MattERoche/Wheelchair-Powermeter/Report and Planning/WhatsApp Image 2025-04-04 at 15.48.07_d8d99685.jpg

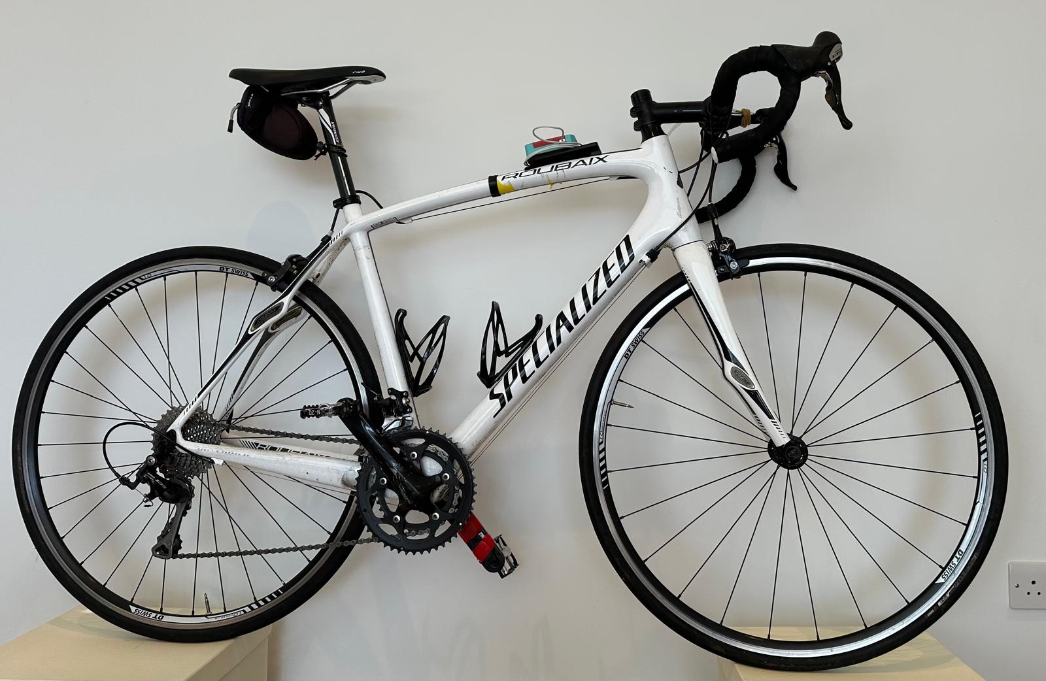
Report and Planning/WhatsApp Image 2025-04-04 at 15.48.07_d8d99685.jpg
