MattERoche/Wheelchair-Powermeter/Report and Planning/WhatsApp Image 2025-04-07 at 23.08.40_146ae403.jpg

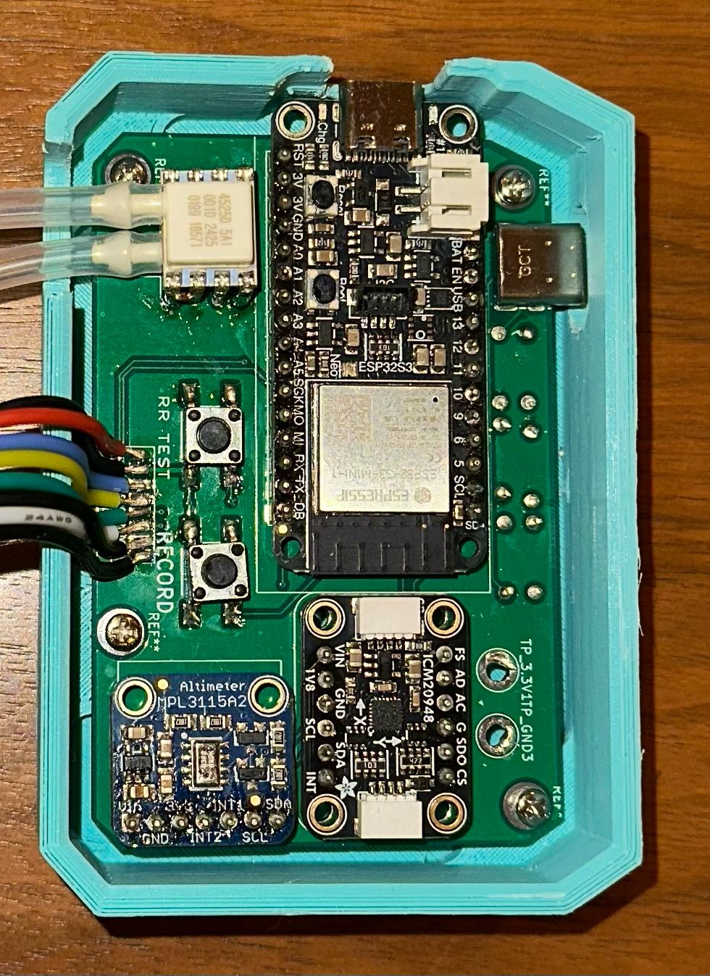
Report and Planning/WhatsApp Image 2025-04-07 at 23.08.40_146ae403.jpg
