MattERoche/Wheelchair-Powermeter/Data_Store/Data_V1_CirPY/Drag% PY.png

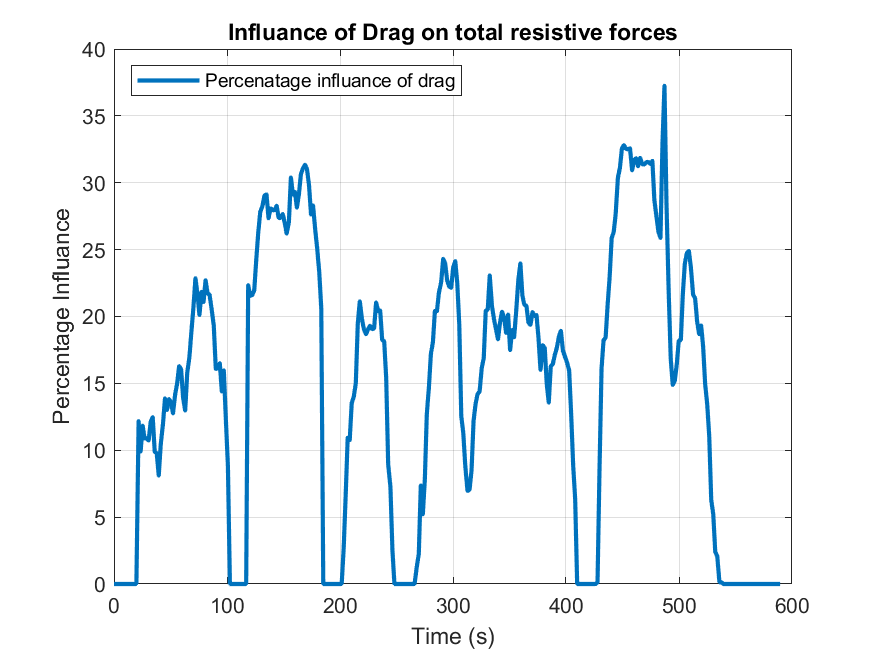
Data_Store/Data_V1_CirPY/Drag% PY.png
