MattERoche/Wheelchair-Powermeter/Data_Store/Data_V1_CirPY/Pitot.png

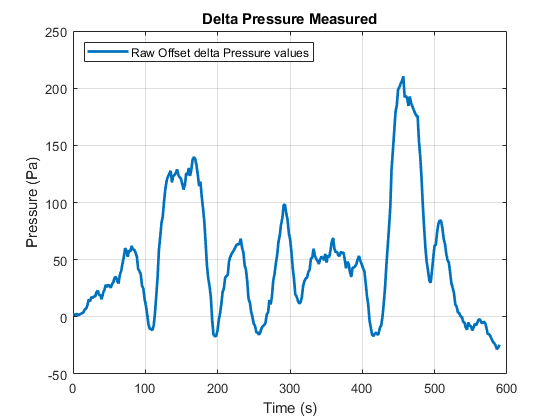
Data_Store/Data_V1_CirPY/Pitot.png
