MattERoche/Wheelchair-Powermeter/Data_Store/Data_V1_CirPY/RR VS Drag PY.png

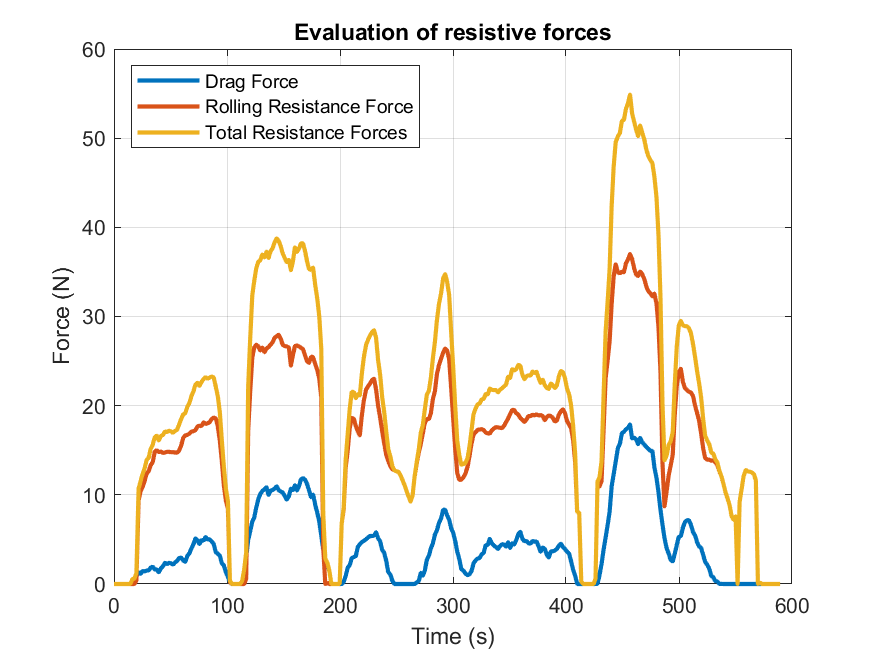
Data_Store/Data_V1_CirPY/RR VS Drag PY.png
