MattERoche/Wheelchair-Powermeter/Data_Store/Data_V1_CirPY/UnfillteredAccel.png

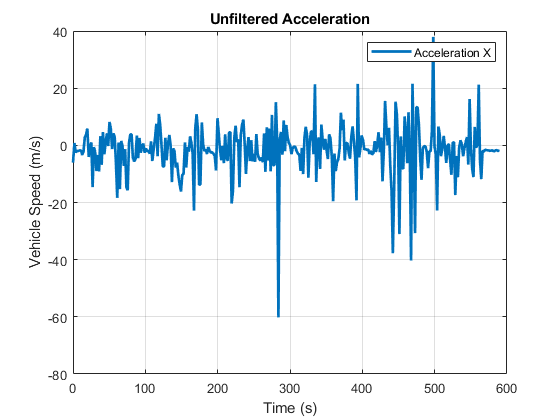
Data_Store/Data_V1_CirPY/UnfillteredAccel.png
