MattERoche/Wheelchair-Powermeter/Data_Store/Data_V1_CirPY/Windspeed vs Vehicle Velocity Circ Py.png

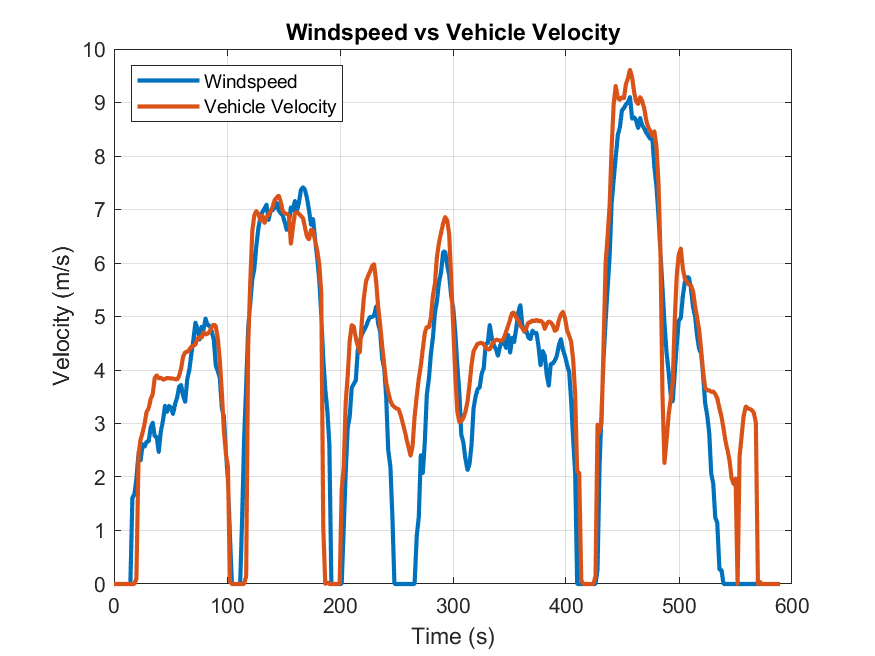
Data_Store/Data_V1_CirPY/Windspeed vs Vehicle Velocity Circ Py.png
