MattERoche/Wheelchair-Powermeter/Data_Store/Data_V2_C++_0330/Accel Vs speed delay.png

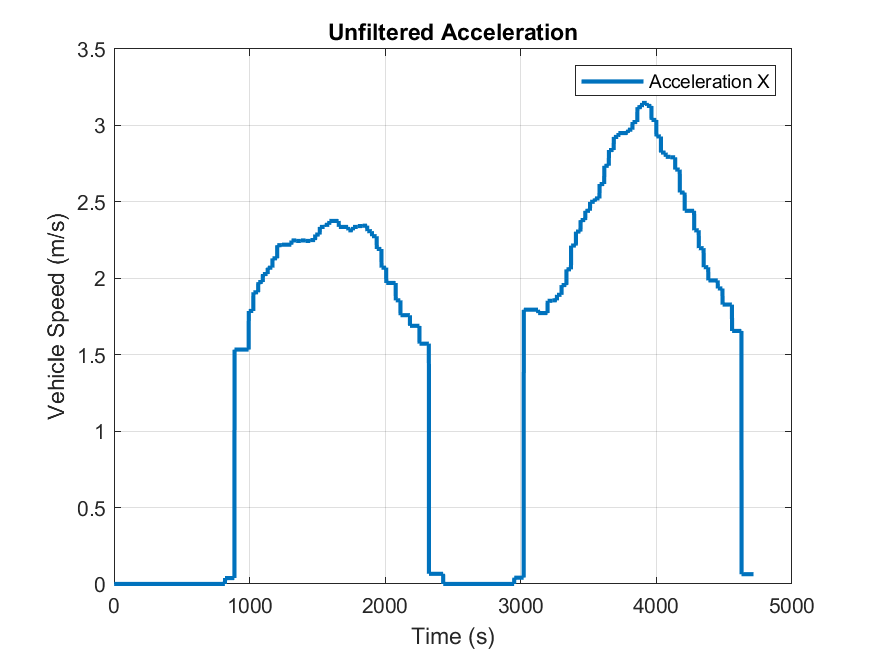
Data_Store/Data_V2_C++_0330/Accel Vs speed delay.png
