MattERoche/Wheelchair-Powermeter/Data_Store/Data_V2_C++_0330/BLE Power Ref.png

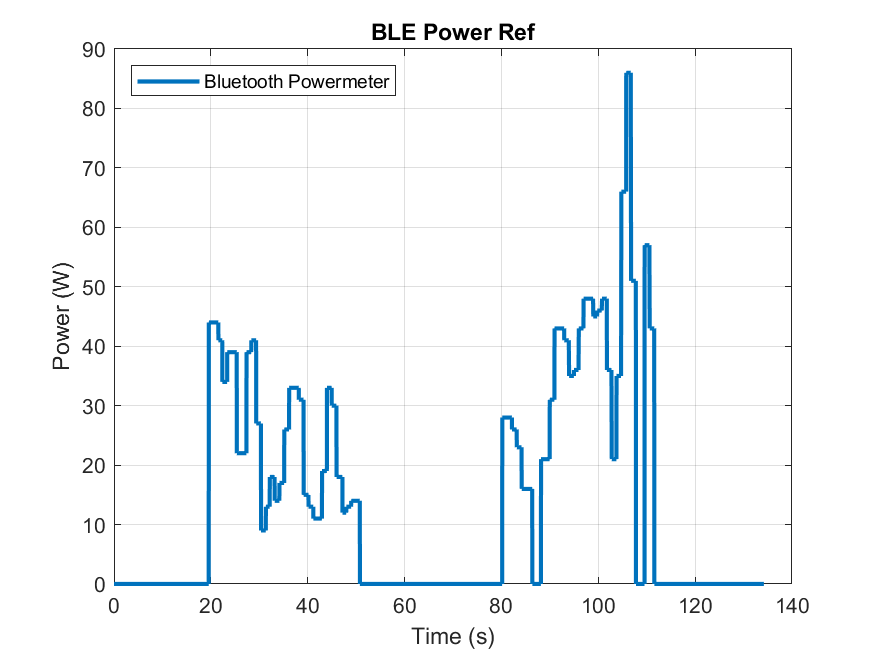
Data_Store/Data_V2_C++_0330/BLE Power Ref.png
