MattERoche/Wheelchair-Powermeter/Data_Store/Data_V2_C++_0330/BLE Velocity Sensor.png

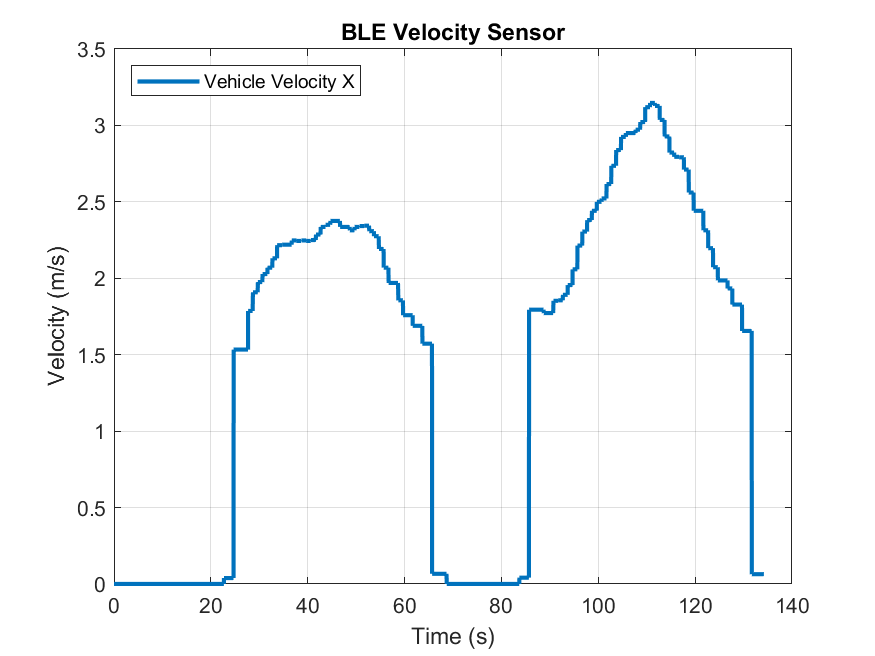
Data_Store/Data_V2_C++_0330/BLE Velocity Sensor.png
