MattERoche/Wheelchair-Powermeter/Data_Store/Data_V2_C++_0330/PowerVsPower.png

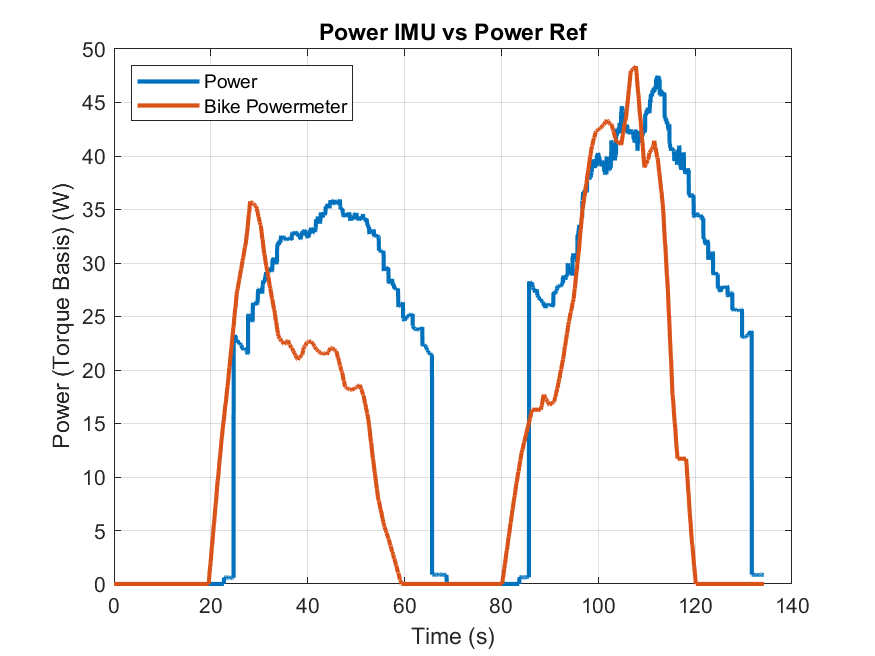
Data_Store/Data_V2_C++_0330/PowerVsPower.png
