MattERoche/Wheelchair-Powermeter/Data_Store/Data_V2_C++_0330/Resistive Forces.png

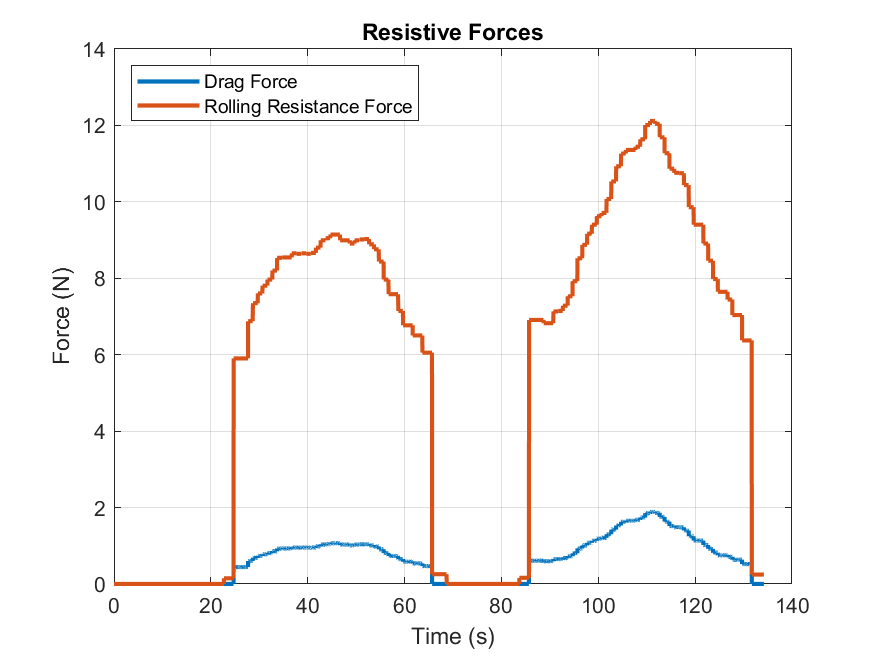
Data_Store/Data_V2_C++_0330/Resistive Forces.png
