MattERoche/Wheelchair-Powermeter/Data_Store/Data_V2_C++_0330/Windspeed vs Vehicle Velocity.png

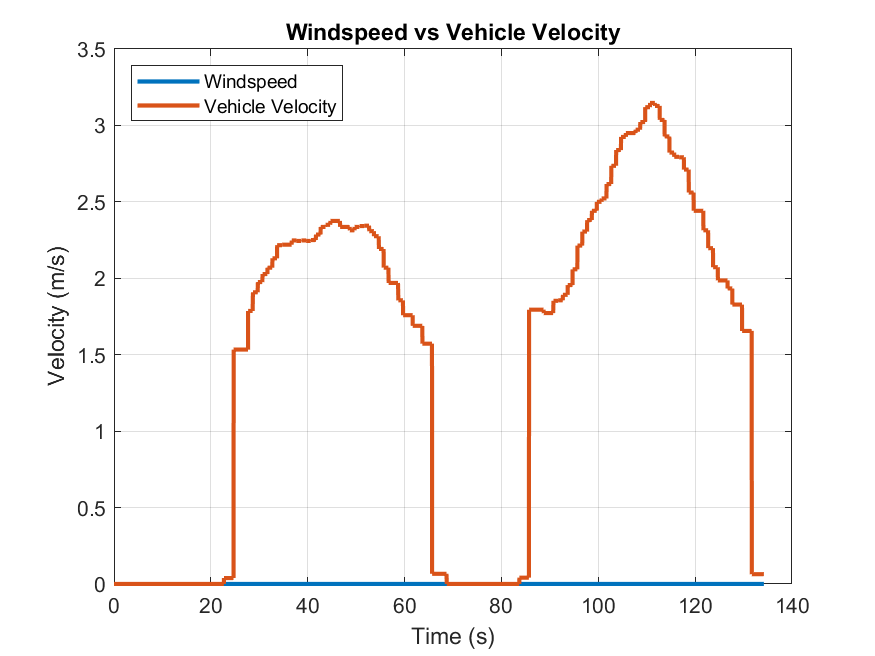
Data_Store/Data_V2_C++_0330/Windspeed vs Vehicle Velocity.png
