MattERoche/Wheelchair-Powermeter/Report and Planning/Fig4 Filter Example.png

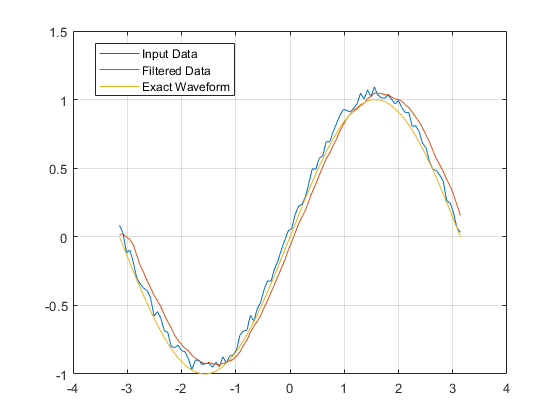
Report and Planning/Fig4 Filter Example.png
