MattERoche/Wheelchair-Powermeter/Report and Planning/Fig5 Filter Shift Example.png

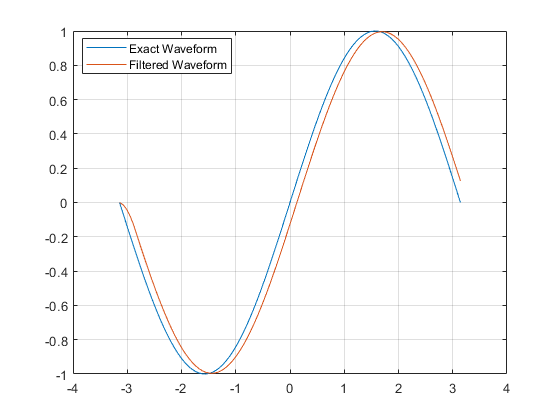
Report and Planning/Fig5 Filter Shift Example.png
