MattERoche/Wheelchair-Powermeter/Report and Planning/Fig_Power.png

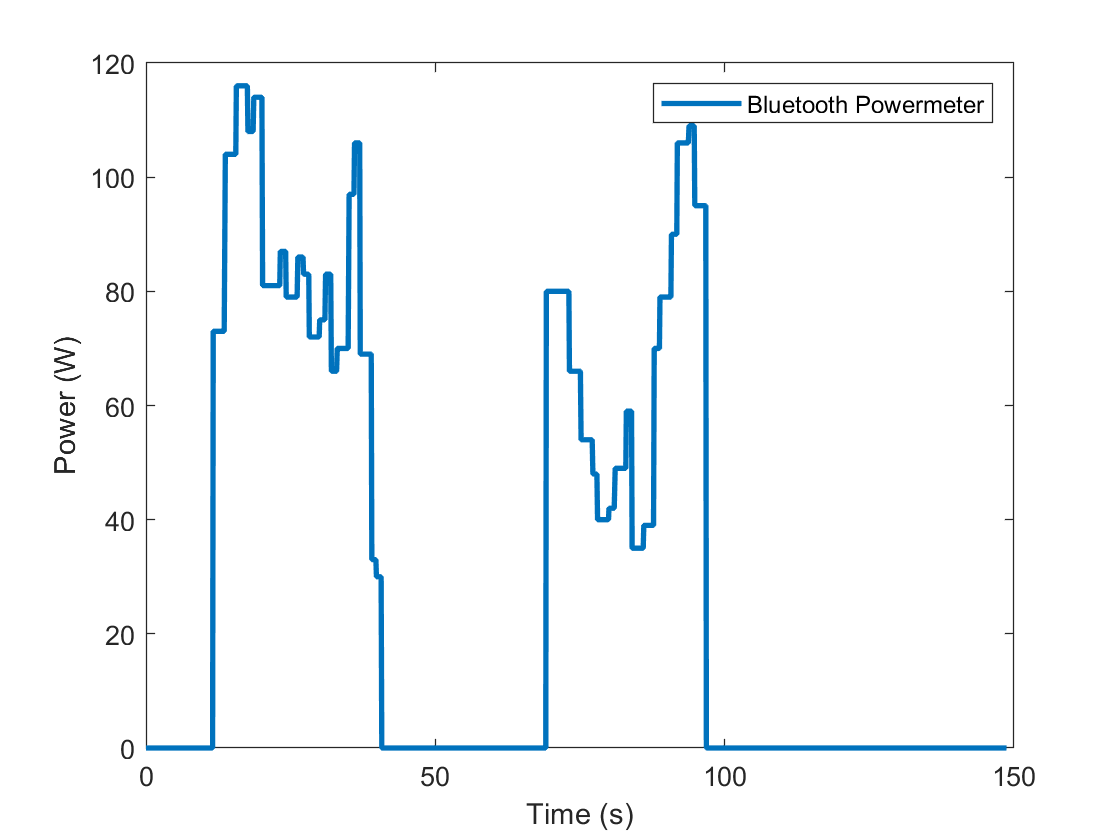
Report and Planning/Fig_Power.png
