MattERoche/Wheelchair-Powermeter/Report and Planning/Fig_speed.png

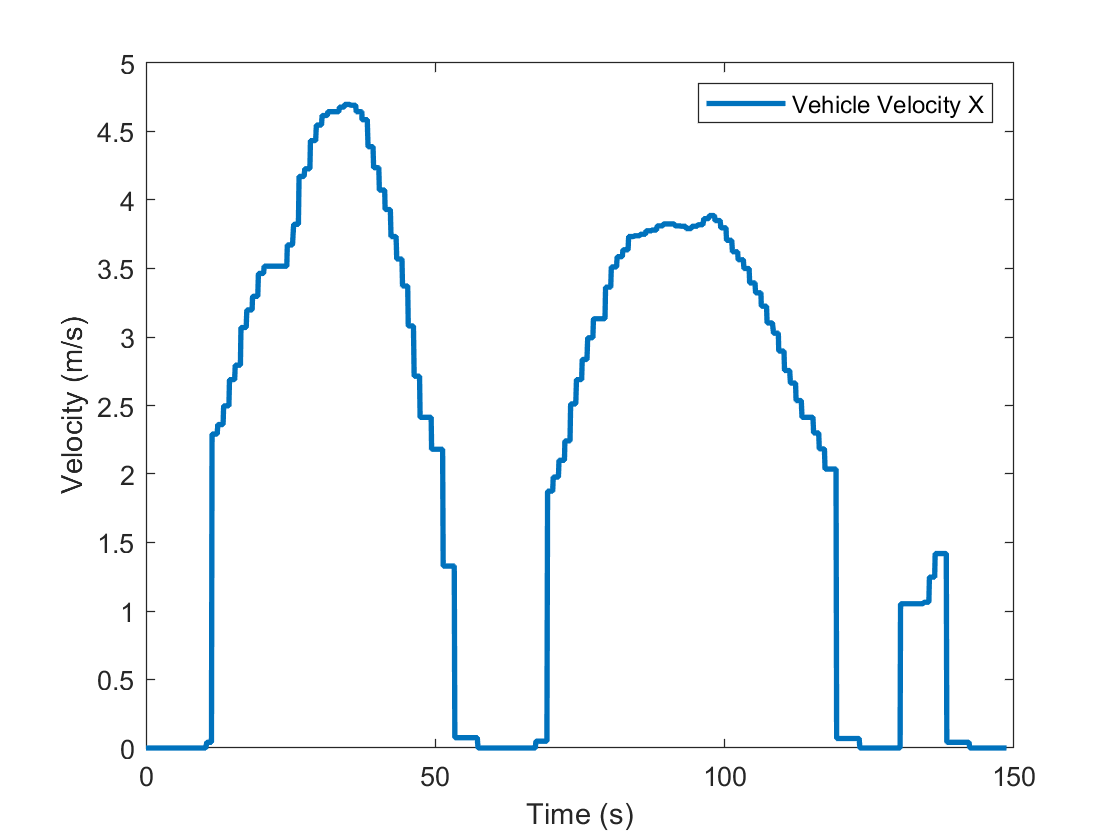
Report and Planning/Fig_speed.png
