MattERoche/Wheelchair-Powermeter/Report and Planning/figure-accellerometer response Run1.png

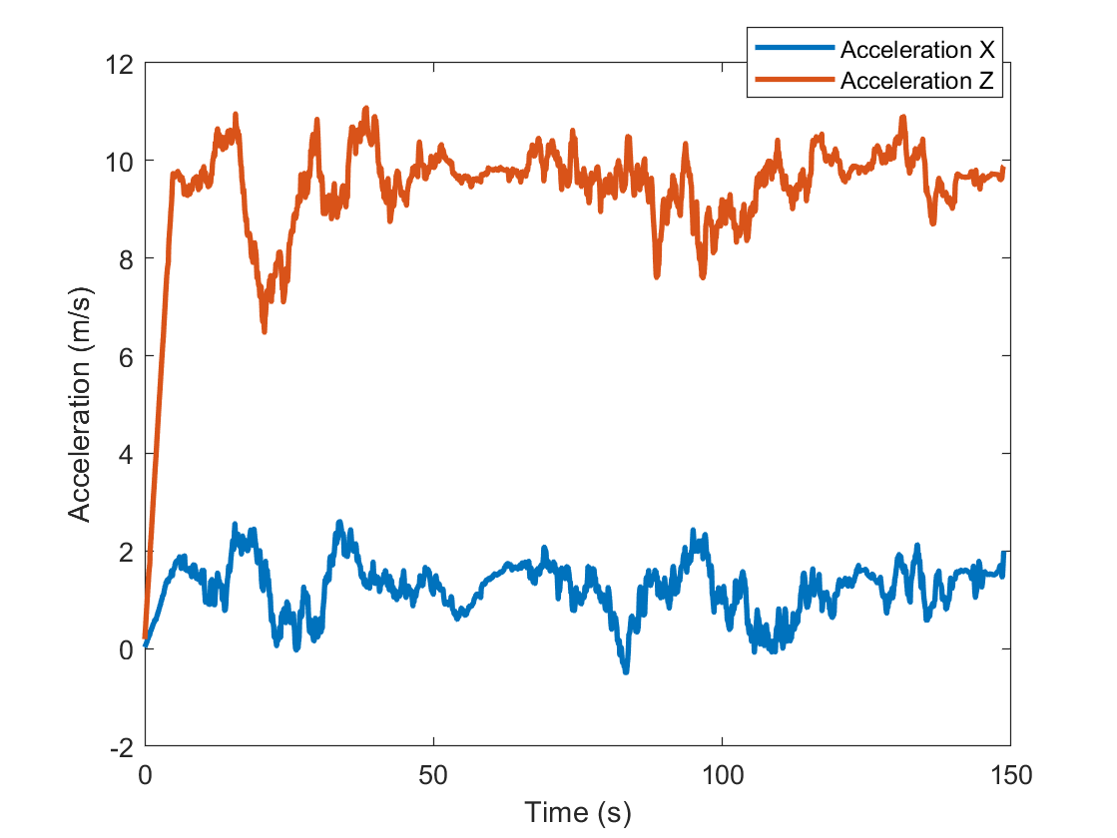
Report and Planning/figure-accellerometer response Run1.png
