MattERoche/Wheelchair-Powermeter/Report and Planning/Figures For Diss-2.jpg

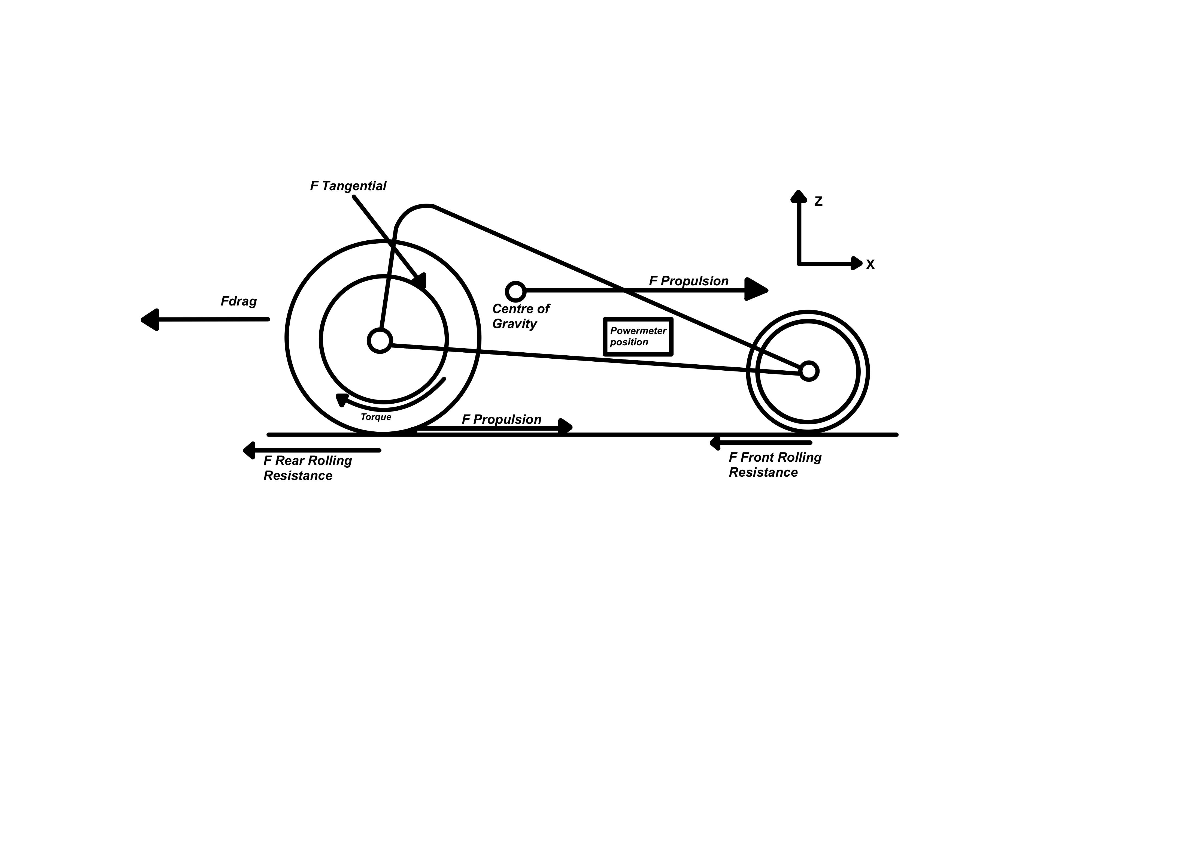
Report and Planning/Figures For Diss-2.jpg
