MattERoche/Wheelchair-Powermeter/Report and Planning/Figures For Diss-5.jpg

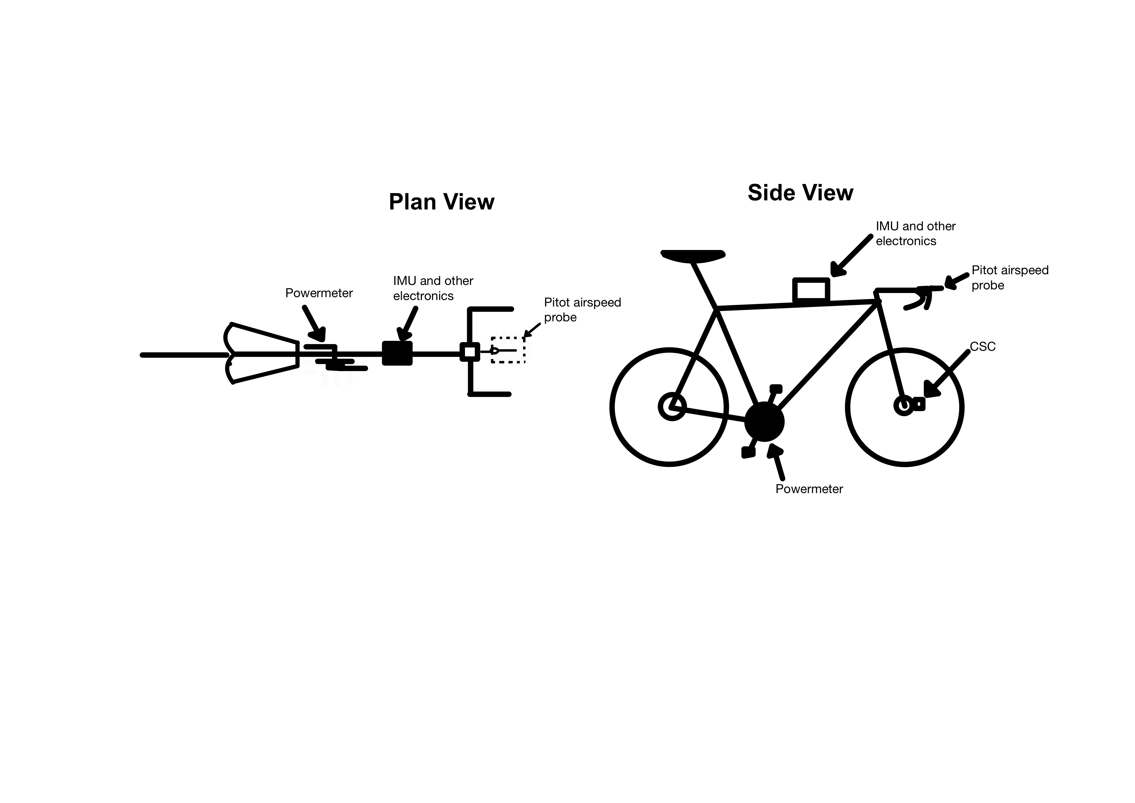
Report and Planning/Figures For Diss-5.jpg
