MattERoche/Wheelchair-Powermeter/Report and Planning/Wheelpower Sensor Flow - Page 2.png

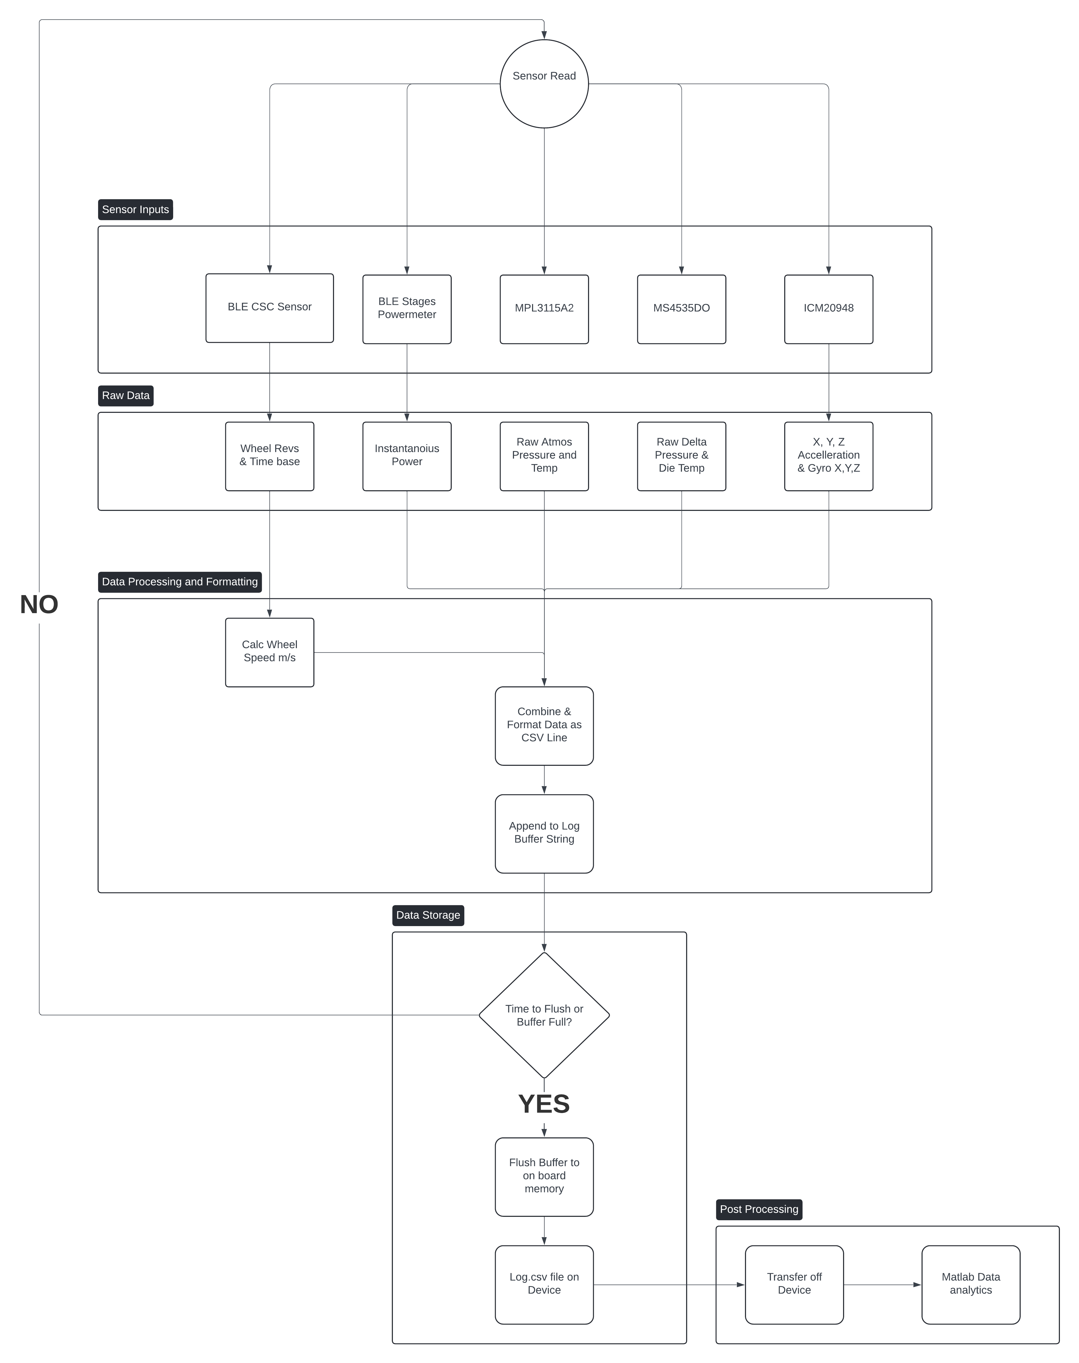
Report and Planning/Wheelpower Sensor Flow - Page 2.png
