MattERoche/Wheelchair-Powermeter/Report and Planning/AHEP4 Learning Outcome Matrix 24-25.xlsx

Students provided with the below AHEP4 Learing Outcome matrix in the style of a risk assessment |  |  |  |  |  |  |  |  | COLUMN K COMPLETED BY ASSESSING STAFF
Students are instructed/required to complete the matrix in full to recieve full marks for this part of the assessment
Students to identify risks/issues concerning their project that align with indicated AHEP4 Learning Outcomes. Students to expand as necessary, but should cover all LO's. |  |  |  |  |  |  |  |  | OVERALL PASS? (Y/N)
PROPOSAL
ASSESSMENT STRATEGY |  | AWARD 5% ONCE ALL ARE GREEN/PASS OR YELLOW/PLANNED (Supervisors to revisit this part of the project plan until all addressed)
Student Name | Matt Roche
Student Number | 19141411
Project Title: | Application and Design of a Training Sensor system to Estimate Input Power for Racing Wheelchair Athletes
Project Aim: | Explore and develop a sensor installation, that estimates average input power for use in wheelchair sports and training with the aim to confidently display a measure of athlete input with road, wind and setup conditions. The aim is for this value to be consistent, to aid in training, as such the value need only be a reasonable estimation of the input so long as the error is carried across multiple use tests.
1. PROPOSAL (MATRIX)
LEARNING OBJECTIVE | STUDENT'S RISK IDENTIFICATION AND DESCRIPTION | LIKELYHOOD (1-5) | IMPACT (1-5) | RISK SCORE (1-25) | MITIGATION DESCRIPTION (COMPLETE IF RISK SCORE IS > 12) | NEW LIKELYHOOD (1-5) | NEW IMPACT (1-5) | NEW RISK SCORE (1-25) | PASS/PLANNED/FAIL
C5: Design solutions for complex problems that meet a combination of societal, user, business and customer needs as appropriate. This will involve consideration of:
C5(a) Applicable health & safety | Testing procedures and risk assesments, during operation the mechanical aspects of the system should be designed and evaluated as to be well within the safety factor required. To minimise risk to equipment or operator. | 3 | 5 | 15 | Testing will be done following Oxford Brookes Health and Safety policies | 1 | 5 | 5 | Pass
C5(b) Diversity, inclusion, cultural, societal needs | Key to the design is that it should fit on as wide a sweep of chair designs and must be able to be fitted to chairs of all paraathletic catagories. Risk is that the system would not be usable by all athletes. | 1 | 2 | 2 |  |  |  |  | Pass
C5(c) Environmental needs | Design will where possible folow a methodoligy of design for repair, and recycling. All componants should be designed where electronics are following (WEEE Directive) and ROHS 2011/65/EU | 2 | 3 | 10 | All componants should be designed where electronics are following (WEEE Directive) and ROHS 2011/65/EU | 2 | 1 | 3 | pass
C5(d) Commercial matters, codes of practice and industry standards
C6: Apply an integrated or systems approach to the solution of complex problems | To be addressed in main project report methodology |  |  |  |  |  |  |  | Planned | Section 3.3
C7: Evaluate the environmental and societal impact of solutions to complex problems and minimise adverse impacts | Shown in the project plan justification, the impact of this system for training of athletes is hopefully large. As described in environmental needs where possible the product of the project will follow RoHS 2011/65/EU | 2 | 3 | 10 |  |  |  |  | Pass
C8: Identify and analyse ethical concerns and make reasoned ethical choices informed by professional codes of conduct | Consequences of research undertaken: This exemplifies the importance of honest data reporting, where issues occur then need to be mentioned as if this is used for its intended purpose, peoples training and therefore health and or livelyhood may be impacted.
 | Involvement of human participants: The only human participant will be myself in this case however care should be taken to ensure I do not put myself in harms way for the project as such appropriate measures as described above will be put in place
 | Reliability and accuracy of the research: All work will be as transparent as possible and raw data and data analysics tools will be available on the GIT Repository for readers perusal
 | Successful completion of the work: Every effort will be taken to follow the timing plan where work planned has not been possible a transparent note shall be made to ensure clarity of the data presented
C10: Adopt a holistic and proportionate approach to the mitigation of security risks | As this project encompasses a vast amount of modelling and software, security of underlying data and software needs to be taken into account. The data security of any participating test subjects and any data individually determained by a user needs to be secure under GDPR legislation. | 3 | 3 | 12 | Data will be held in software industry standard. Version management systems. Personal data will not be held unless consent is given past the end of the project time | 1 | 3 | 3 | Pass
C11: Adopt an inclusive approach to engineering practice and recognise the responsibility, benefits and importance of supporting equality, diversity and inclusivity | To be addressed in main project report via EDI statement |  |  |  |  |  |  |  | Planned | Section 1.4
C15: Apply knowledge of engineering management principles, commercial context, project and change management, and relevant legal matters including intellectual property rights
C15 (a) Commercial contexts | Assuming the costing of an electrical and software engineer, for an expected 300 man hour project at £40,000 per year rate, an estimated £15 per hour. People time cost is circa £4500. Including R&D Parts costing of estimated £100. Total project costs are in the region of £4600. post R&D work the financial benifit can be estimated by understanding the participation at a high level of wheelchair racing in 2014 there were 177 classified wheelchair racers, assuming no amatur racers were interested in data based training that would be 177 coached national level atheletes as a customer pool. With parts cost estimated at £55 a price of £80 would recoup R&D Costs for the whole project if only nationally ranked atheletes made orders.
C15 (b) Intellectual propertry risks | TU Delft and Marit Van Dijk may intelectual property around some of this technology and underlying theory. So far no patents for this technologies have been filed
C15 (c) Gannt Chart (project schedule risks) | The project test should be completed by early March leaving time to evaluate the efficacy of the system and objectives for future extended development. Slipping of this timeline will constrict the time to write the project conclusions
 |  |  |  |  | Students to achieve this standard (highlighted) for the Gantt Chart
Assessment guidance |  | 0 | 1 or 2 | 3 or 4 | 5 or 6 | 7 or 8 | 9 or 10
Risk Assessment | C9 | Risk not discussed at all. | Risk briefly mentioned. | A few risks identified and briefly discussed with limited mitigation strategy. An attempt of a very small matrix. | Suitable range of risks identified, and presented in a matrix. Risks discussed but mitigation strategy limited. | Good range of risks identified, evaluated appropriately and presented in a good risk matrix. Good discussion of mitigation strategy with appropriate mitigation strategy. | Excellent range of risk identified, evaluated appropriately and presented in a comprehensive risk matrix. Detailed discussion of mitigation strategy with appropriate contingency planning.
Gantt Chart | C15 | Hard to read with insufficient detail. Resources not considered in any detail. | Not very easy to follow, with few milestones and activities stated, many with inappropriate time allocation. Brief mention of resources required but not discussed. | Milestones and tasks clearly stated with mostly appropriate timescales assigned. Some discussion of the resources required but with limited task breakdown. | Milestones and tasks clearly stated with appropriate timescales assigned, chart presented well including a legend. Good discussion of the resources required with limited consideration on potential issues but no contingency planning. | Milestones and tasks clearly stated with appropriate timescales assigned, critical path included with activities for each task stated; chart presented well including a legend. Detailed discussion of the resources required with some consideration on potential issues and some contingency planning. | Milestones and tasks clearly stated with appropriate timescales assigned, critical path included with activities for each task stated and appropriate risk evaluation embedded. Chart presented well including a legend. Detailed discussion of the resources required with detailed consideration on potential issues with appropriate contingency planning.
