MattERoche/Wheelchair-Powermeter/PCB_CAD_Files/Symbols and Footprints Library/Airspeed/4525-DS5A001DP.step

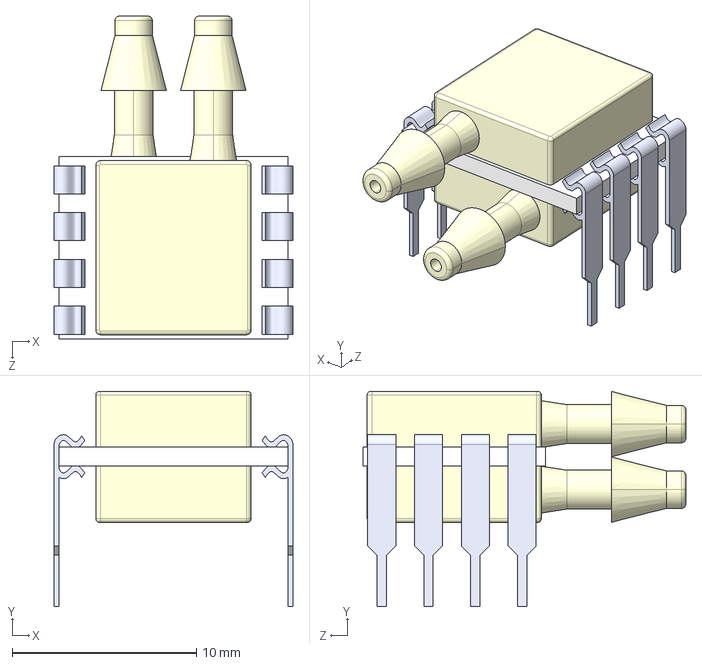
[picture p37: CAD file, 2025-03-03]
PCB_CAD_Files/Symbols and Footprints Library/Airspeed/4525-DS5A001DP.step
13.0 x 11.7 x 17.5 mm
