MattERoche/Wheelchair-Powermeter/PCB_CAD_Files/Symbols and Footprints Library/HP0315AFKP2.stp

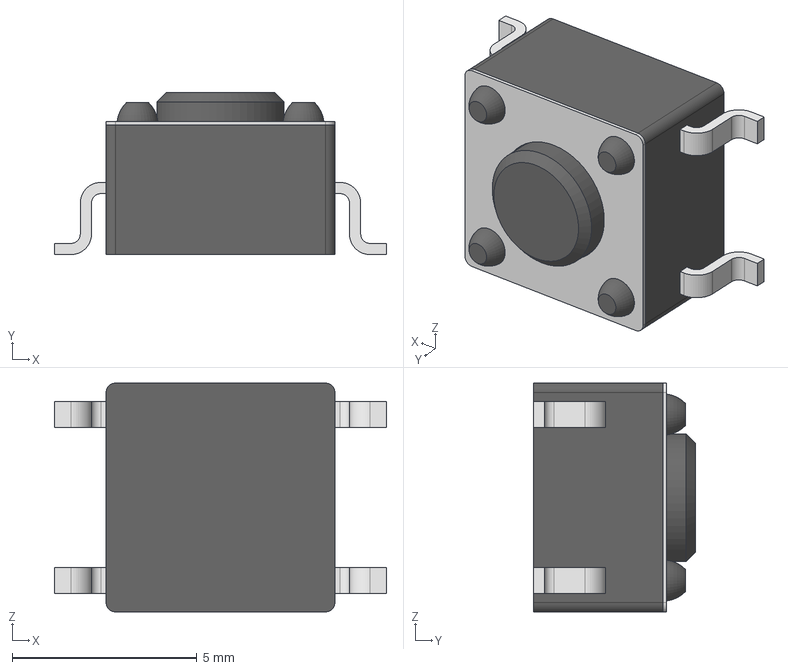
[picture p38: CAD file, 2025-03-10]
PCB_CAD_Files/Symbols and Footprints Library/HP0315AFKP2.stp
8.99 x 4.39 x 6.20 mm
hp03-body
hp03-cap
hp03-button
hp03-pinn-P2 x 4
