MattERoche/Wheelchair-Powermeter/PCB_CAD_Files/Symbols and Footprints Library/USBC/USB4085-GF-A_REVB.step

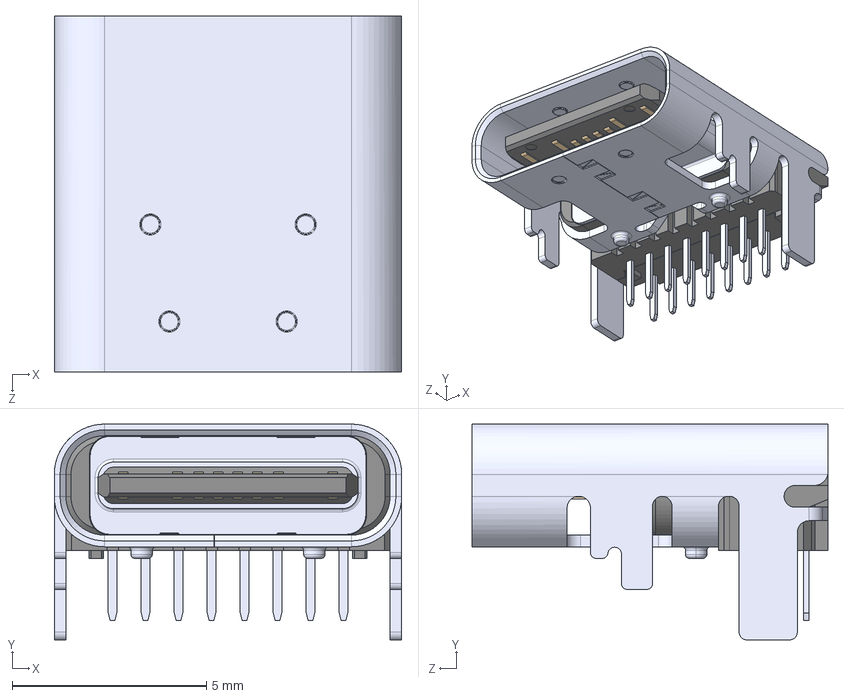
[picture p39: CAD file, 2025-03-03]
PCB_CAD_Files/Symbols and Footprints Library/USBC/USB4085-GF-A_REVB.step
8.95 x 5.56 x 9.17 mm
