MattERoche/Wheelchair-Powermeter/PCB_CAD_Files/PCB Files/Wheelchair Powermeter PCBV2.step

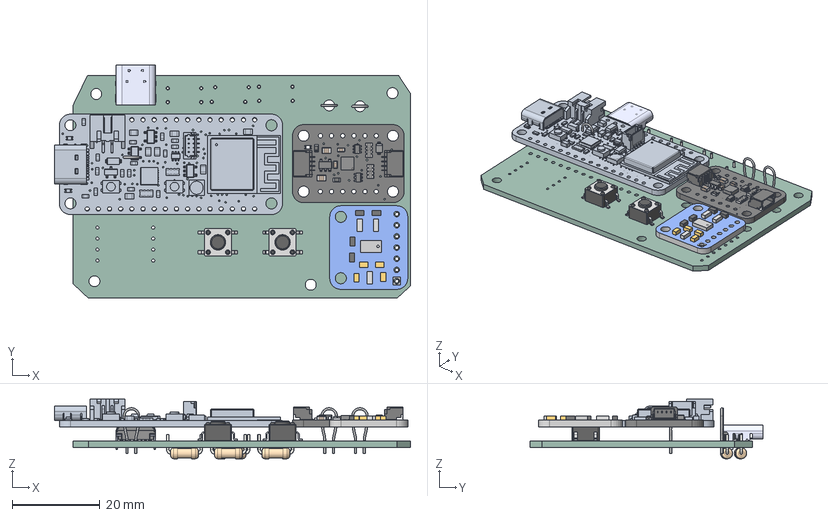
[picture p40: CAD file, 2025-03-31]
PCB_CAD_Files/PCB Files/Wheelchair Powermeter PCBV2.step
81.0 x 53.1 x 13.5 mm
hp03-body x 2
hp03-cap x 2
hp03-button x 2
hp03-pinn-P2 x 8
TestPoint_Loop_D3.80mm_Drill2.5mm x 3
1893 Altimeter MLP3115A2
Wheelchair Powermeter PCBV2 1.6.1
USB4085-GF-A_REVB
Printed Circuit Board
ICM-20948-9axis-IMU v2
SOT23-5 v1
LED 0603 single color v1
Cathode
Anode
Cathode Bar
CAPC-0603-T0.9-BN v1 x 2
CAPC-0805-T0.95-BN v1 x 2
RESC-0603 v1 x 2
YC164_RESPACK v1 x 2
qwicc v1 x 2
R_Axial_DIN0207_L6.3mm_D2.5mm_P7.62mm_Horizontal x 6
Wheelchair Powermeter PCB_PCB
