MattERoche/Wheelchair-Powermeter/PCB_CAD_Files/PCB_Casing/PCB case STLS/004_Tray_V2.stl

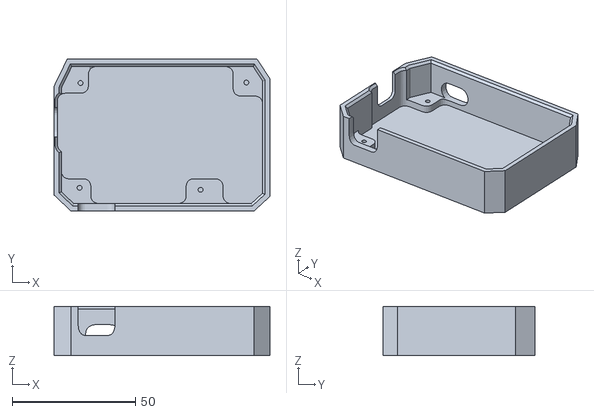
[picture p41: CAD file, 2025-03-31]
PCB_CAD_Files/PCB_Casing/PCB case STLS/004_Tray_V2.stl
87.8 x 61.7 x 20.0
