MattERoche/Wheelchair-Powermeter/PCB_CAD_Files/PCB_Casing/PCB case STLS/003_Case_V2_2.stl

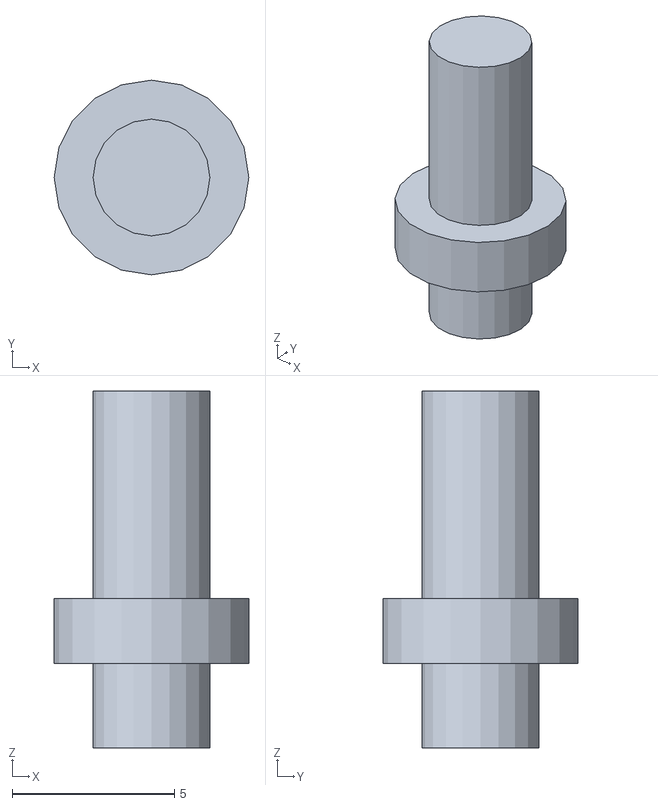
[picture p42: CAD file, 2025-03-31]
PCB_CAD_Files/PCB_Casing/PCB case STLS/003_Case_V2_2.stl
6.00 x 6.00 x 11.0
