MattERoche/Wheelchair-Powermeter/PCB_CAD_Files/PCB_Casing/PCB case STLS/004-PART-TRAY.stl

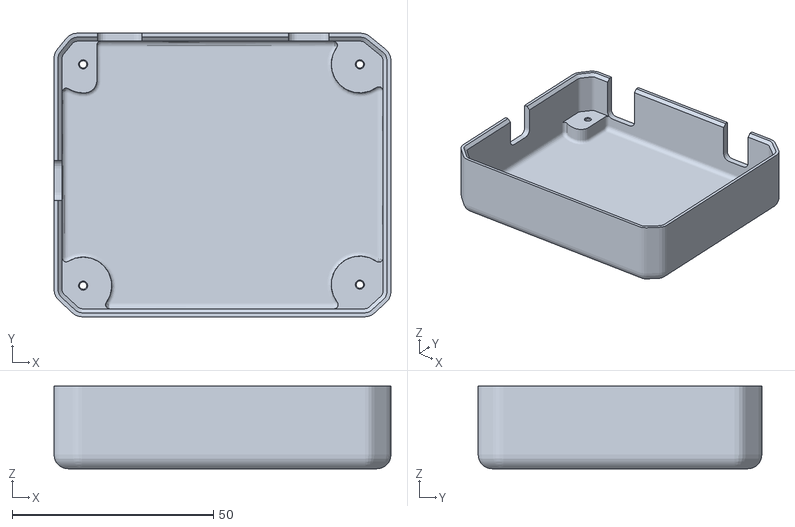
[picture p43: CAD file, 2025-03-24]
PCB_CAD_Files/PCB_Casing/PCB case STLS/004-PART-TRAY.stl
83.8 x 70.5 x 20.5
