MattERoche/Wheelchair-Powermeter/PCB_CAD_Files/PCB_Casing/PCB case STLS/003_Case_V2_1.stl

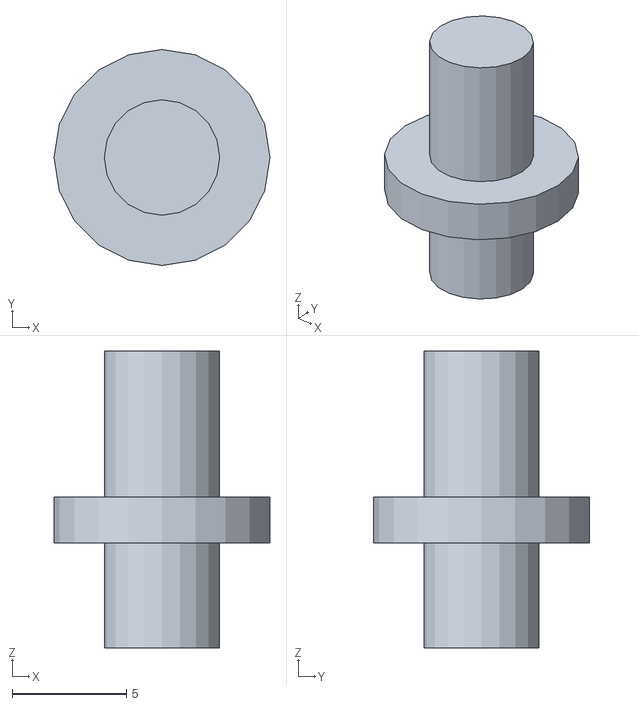
[picture p44: CAD file, 2025-03-31, an earlier design]
PCB_CAD_Files/PCB_Casing/PCB case STLS/003_Case_V2_1.stl
9.45 x 9.45 x 13.0
