MattERoche/Wheelchair-Powermeter/PCB_CAD_Files/PCB_Casing/PCB case STLS/003_Case_V2.stl

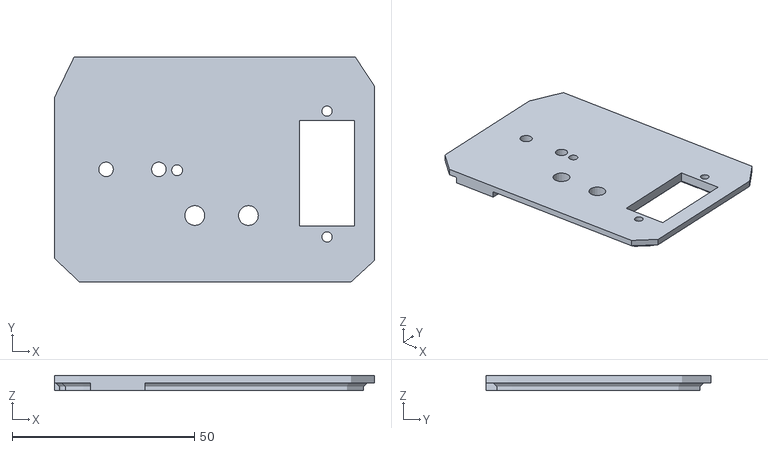
[picture p45: CAD file, 2025-03-31, an earlier design]
PCB_CAD_Files/PCB_Casing/PCB case STLS/003_Case_V2.stl
87.8 x 61.7 x 4.00
