MattERoche/Wheelchair-Powermeter/(list of files, cad)

Other CAD files:
PCB_CAD_Files/PCB_Casing/001-ASSY-POWERMETER.prt
PCB_CAD_Files/PCB_Casing/002-ASSY-EL-PCB.prt
PCB_CAD_Files/PCB_Casing/003-ASSY-CASE.prt
PCB_CAD_Files/PCB_Casing/004-PART-TRAY.prt
PCB_CAD_Files/PCB_Casing/005-PART-LID.prt
PCB_CAD_Files/PCB_Casing/006-PART-BUTTONPUSHER.prt
PCB_CAD_Files/PCB_Casing/007-PART-GLASS.prt
PCB_CAD_Files/PCB_Casing/PCBCASE_V2/002_PCB_V2.prt
PCB_CAD_Files/PCB_Casing/PCBCASE_V2/003_Case_V2.prt
PCB_CAD_Files/PCB_Casing/PCBCASE_V2/004_Tray_V2.prt
PCB_CAD_Files/PCB_Casing/PCBCASE_V2/005_Lid_V2.prt
PCB_CAD_Files/PCB_Casing/PCBCASE_V2/ButtonA.prt
PCB_CAD_Files/PCB_Casing/PCBCASE_V2/ButtonB.prt
PCB_CAD_Files/PCB_Casing/PCBCASE_V2/Wheelchair Powermeter V2.prt
