MattERoche/Wheelchair-Powermeter/Data_Store/Data_V2_C++_0330/100hz_Test_Deck.csv

Time | AccelX | AccelY | AccelZ | GyroX | GyroY | GyroZ | Pressure | Temp | DeltaP | AirspeedTemp | Speed | Power | Airspeed
66.712 | 2.11 | 0.27 | 9.77 | -0.03 | 0.01 | 0.02 | 1023.8 | 35.5 | -41.6 | 22.2 | 0.00 | 0 | 0.00
66.737 | 2.03 | 0.18 | 9.87 | -0.03 | 0.01 | 0.02 | 1023.4 | 35.3 | -43.7 | 22.2 | 0.00 | 0 | 0.00
66.762 | 2.05 | 0.14 | 9.82 | -0.02 | 0.00 | 0.01 | 1023.7 | 35.4 | -44.7 | 22.2 | 0.00 | 0 | 0.00
66.787 | 2.10 | 0.11 | 9.81 | -0.02 | 0.00 | 0.01 | 1024.0 | 35.5 | -44.7 | 22.2 | 0.00 | 0 | 0.00
66.812 | 2.08 | 0.21 | 9.82 | -0.02 | 0.01 | 0.01 | 1023.9 | 35.4 | -43.7 | 22.2 | 0.00 | 0 | 0.00
66.837 | 2.01 | 0.18 | 9.81 | -0.02 | 0.01 | 0.01 | 1024.4 | 35.5 | -46.8 | 22.2 | 0.00 | 0 | 0.00
66.879 | 2.02 | 0.20 | 9.84 | -0.01 | 0.00 | 0.01 | 1024.2 | 35.6 | -41.6 | 22.2 | 0.00 | 0 | 0.00
66.904 | 2.05 | 0.20 | 9.84 | -0.01 | 0.01 | 0.01 | 1023.8 | 35.4 | -40.5 | 22.2 | 0.00 | 0 | 0.00
66.929 | 2.15 | 0.22 | 9.81 | -0.01 | 0.00 | 0.01 | 1023.9 | 35.6 | -41.6 | 22.2 | 0.00 | 0 | 0.00
66.954 | 2.13 | 0.32 | 9.81 | -0.01 | 0.01 | 0.02 | 1023.5 | 35.5 | -40.5 | 22.2 | 0.00 | 0 | 0.00
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
