MattERoche/Wheelchair-Powermeter/Data_Store/Data_V2_C++_0330/100hz_Test_Deck_PowerCadance.csv

Time | AccelX | AccelY | AccelZ | GyroX | GyroY | GyroZ | Pressure | Temp | DeltaP | AirspeedTemp | Speed | Power | Airspeed | Cadence(rad/s)
81.550 | 1.58 | -1.03 | 10.33 | -0.01 | -0.00 | 0.02 | 1024.0 | 37.0 | -46.8 | 25.3 | 0.00 | 0 | 0.00 | 0.00
81.641 | 2.48 | 0.25 | 9.39 | 0.02 | 0.02 | 0.04 | 1024.2 | 37.1 | -43.7 | 25.3 | 0.00 | 0 | 0.00 | 0.00
81.670 | 1.07 | 1.31 | 6.93 | -0.31 | 0.03 | -0.02 | 1023.9 | 37.1 | -46.8 | 25.3 | 0.00 | 0 | 0.00 | 0.00
81.695 | 0.90 | 0.39 | 9.33 | 0.10 | 0.02 | -0.01 | 1023.9 | 37.0 | -44.7 | 25.3 | 0.00 | 0 | 0.00 | 0.00
81.720 | 1.56 | -1.18 | 10.10 | -0.09 | 0.02 | -0.01 | 1023.9 | 37.2 | -43.7 | 25.3 | 0.00 | 0 | 0.00 | 0.00
81.745 | 2.03 | -0.13 | 9.86 | 0.09 | 0.00 | -0.02 | 1024.2 | 37.1 | -43.7 | 25.3 | 0.00 | 0 | 0.00 | 0.00
81.770 | 1.72 | -0.55 | 9.74 | -0.03 | 0.01 | -0.01 | 1024.0 | 37.1 | -46.8 | 25.3 | 0.00 | 0 | 0.00 | 0.00
81.795 | 1.61 | -0.26 | 10.11 | -0.02 | 0.00 | -0.01 | 1024.0 | 37.0 | -43.7 | 25.3 | 0.00 | 0 | 0.00 | 0.00
81.820 | 1.52 | -0.53 | 10.05 | -0.03 | -0.00 | -0.01 | 1024.2 | 37.1 | -40.5 | 25.3 | 0.00 | 0 | 0.00 | 0.00
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
