MattERoche/Wheelchair-Powermeter/PCB_CAD_Files/PCB Files/Wheelchair Powermeter PCB.kicad_pcb

## KiCad design PCB_CAD_Files/PCB Files/Wheelchair Powermeter PCB.kicad_pcb (2025-04-02)

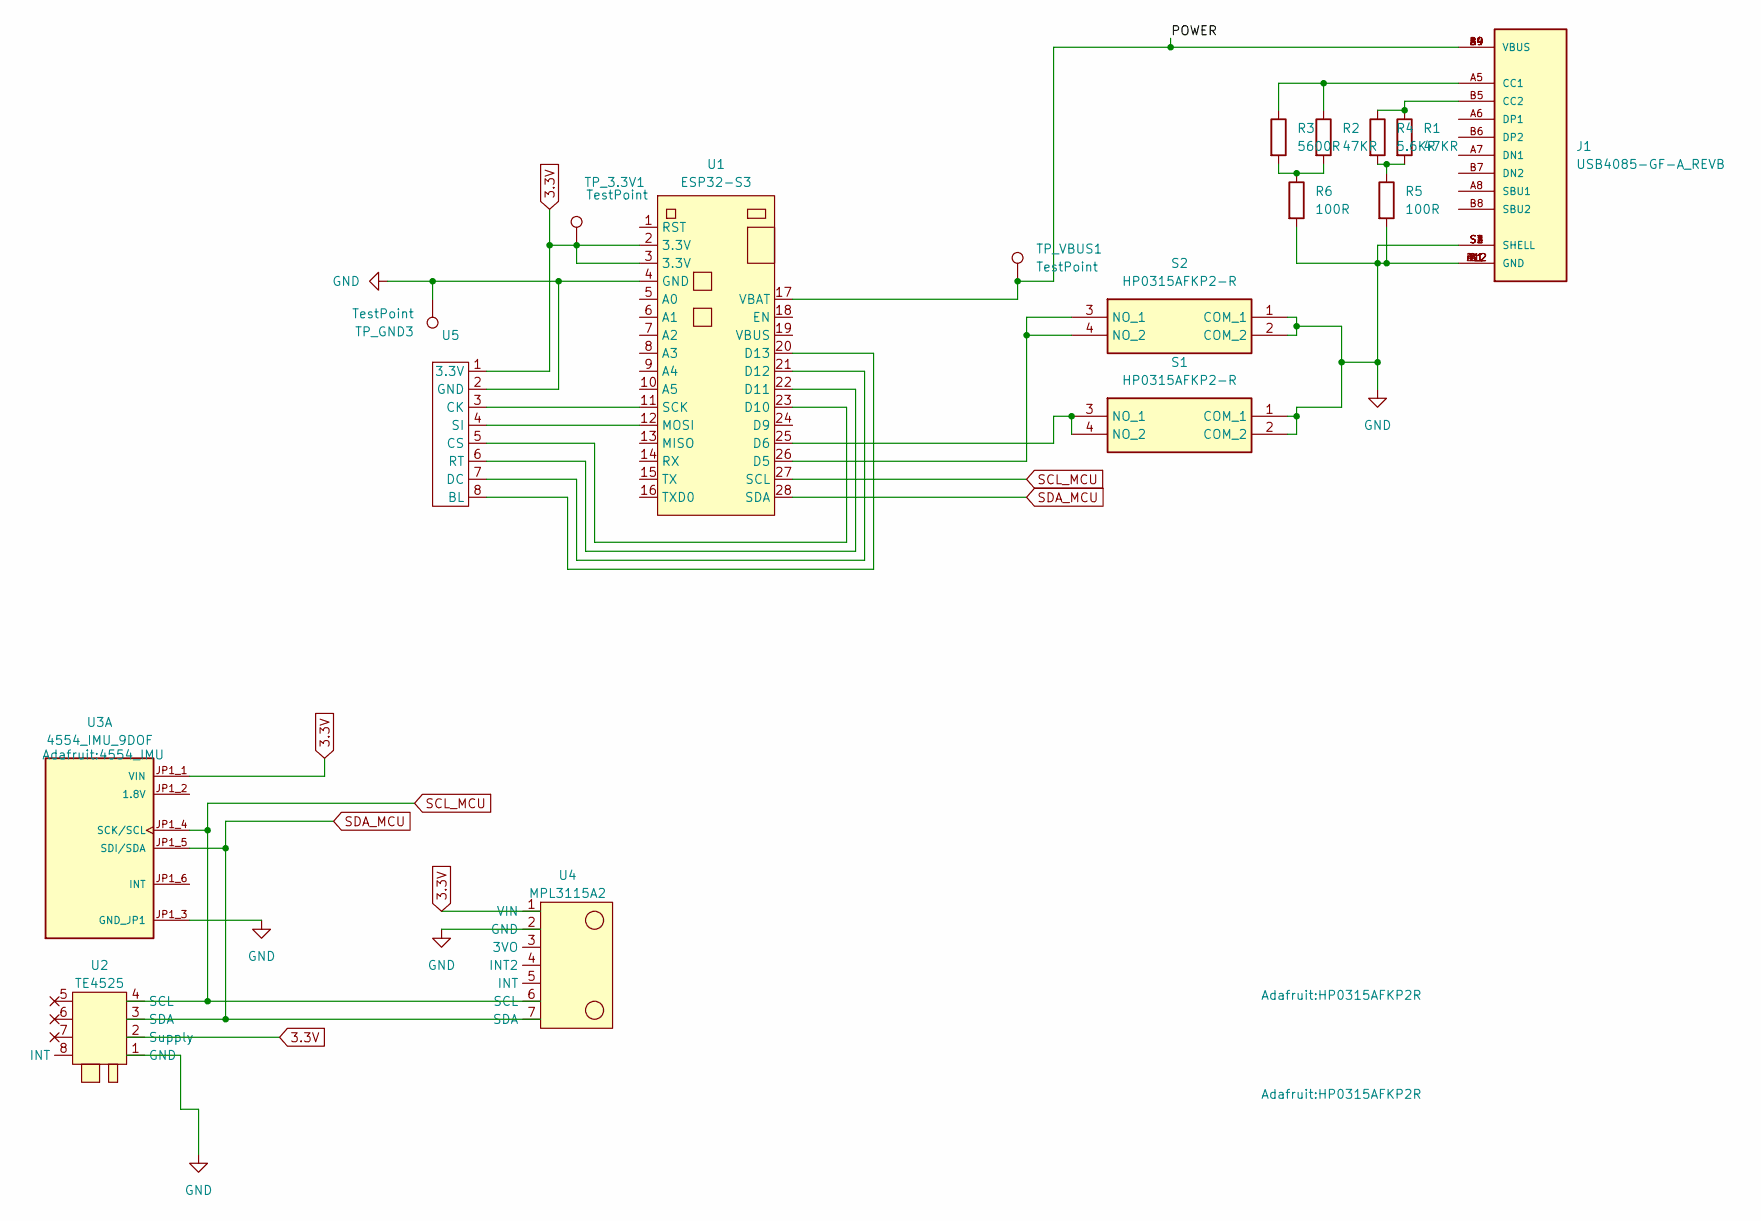
[picture p46: schematic Wheelchair Powermeter PCB.kicad_sch]

Parts:
J1: USB4085-GF-A_REVB; GCT_USB4085-GF-A_REVB; PARTREV B
R1, R2: 47KR; R_Axial_DIN0207_L6.3mm_D2.5mm_P7.62mm_Horizontal
R3: 5600R; R_Axial_DIN0207_L6.3mm_D2.5mm_P7.62mm_Horizontal
R4: 5.6KR; R_Axial_DIN0207_L6.3mm_D2.5mm_P7.62mm_Horizontal
R5, R6: 100R; R_Axial_DIN0207_L6.3mm_D2.5mm_P7.62mm_Horizontal
S1, S2: HP0315AFKP2-R; HP0315AFKP2R; Mouser Part Number 633-HP0315AFKP2-R
TP_3.3V1: TestPoint; TestPoint_Loop_D3.80mm_Drill2.5mm
TP_GND3: TestPoint; TestPoint_Loop_D3.80mm_Drill2.5mm
TP_VBUS1: TestPoint; TestPoint_Loop_D3.80mm_Drill2.5mm
U1: ESP32-S3
U2: TE4525; TE_4525-DS5A001DP
U3: 4554_IMU_9DOF; 4554_IMU; PARTREV N/A
U4: MPL3115A2; MPL311
U5: SPI_Screen

Connections:
3.3V: TP_3.3V1.1, U1.2 (3.3V), U1.3 (3.3V), U2.2 (Supply), U3.JP1_1 (VIN), U4.1 (VIN), U5.1 (3.3V)
/POWER: J1.A4 (VBUS), J1.A9 (VBUS), J1.B4 (VBUS), J1.B9 (VBUS), TP_VBUS1.1, U1.17 (VBAT)
GND: J1.A1 (GND), J1.A12 (GND), J1.B1 (GND), J1.B12 (GND), J1.S1 (SHELL), J1.S2 (SHELL), J1.S3 (SHELL), J1.S4 (SHELL), R5.2, R6.2, S1.1 (COM_1), S1.2 (COM_2), S2.1 (COM_1), S2.2 (COM_2), TP_GND3.1, U1.4 (GND), U2.1 (GND), U3.JP1_3 (GND_JP1), U4.2 (GND), U5.2 (GND)
unnamed: J1.A5 (CC1), R2.1, R3.1
unnamed: J1.B5 (CC2), R1.1, R4.1
unnamed: R1.2, R4.2, R5.1
unnamed: R2.2, R3.2, R6.1
unnamed: S1.3 (NO_1), S1.4 (NO_2), U1.25 (D6)
unnamed: S2.3 (NO_1), S2.4 (NO_2), U1.26 (D5)
unnamed: U1.23 (D10), U5.5 (CS)
unnamed: U1.22 (D11), U5.6 (RT)
unnamed: U1.21 (D12), U5.7 (DC)
unnamed: U1.20 (D13), U5.8 (BL)
unnamed: U1.12 (MOSI), U5.4 (SI)
unnamed: U1.11 (SCK), U5.3 (CK)
SCL_MCU: U1.27 (SCL), U2.4 (SCL), U3.JP1_4 (SCK/SCL), U4.6 (SCL)
SDA_MCU: U1.28 (SDA), U2.3 (SDA), U3.JP1_5 (SDI/SDA), U4.7 (SDA)

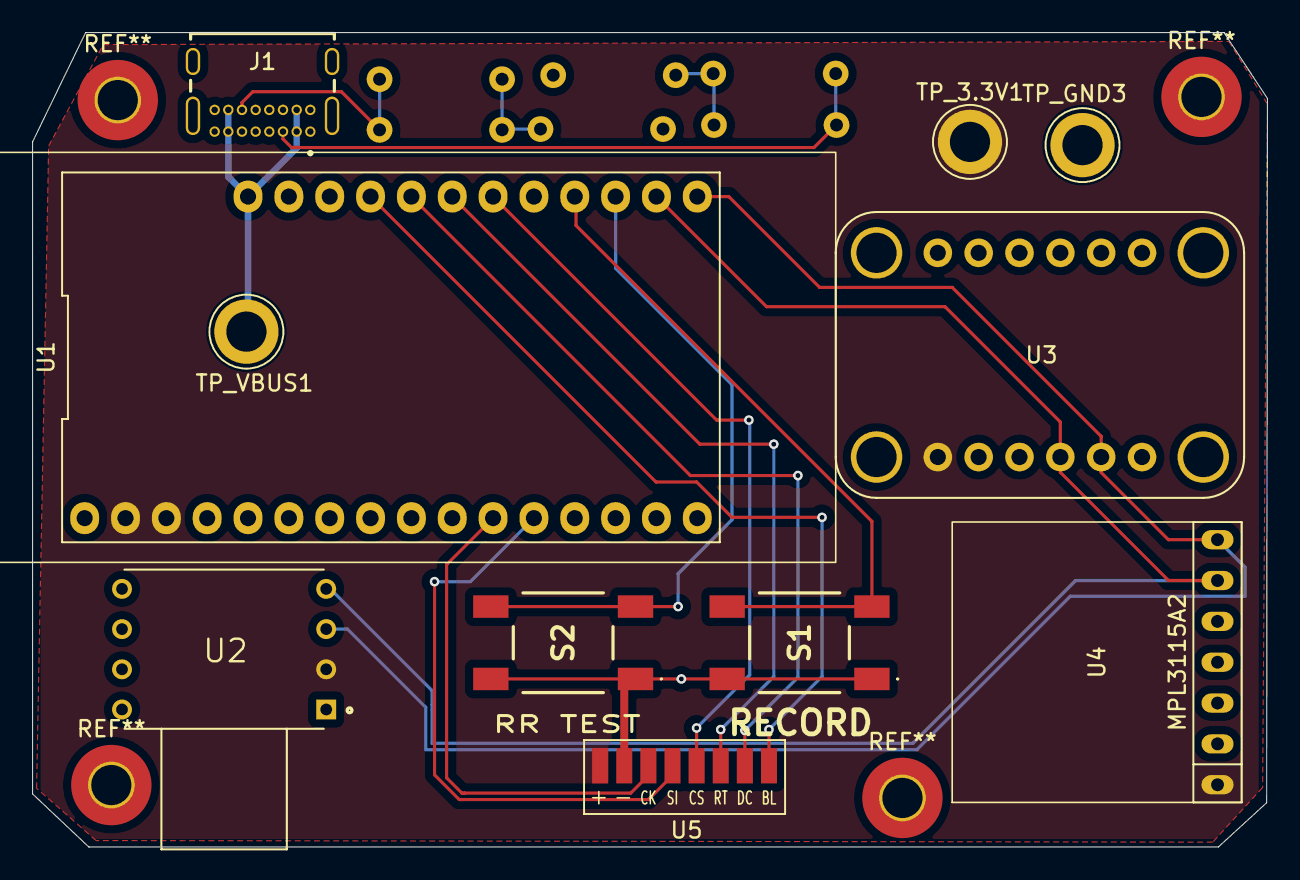
[picture p47: board Wheelchair Powermeter PCB.kicad_pcb from above]

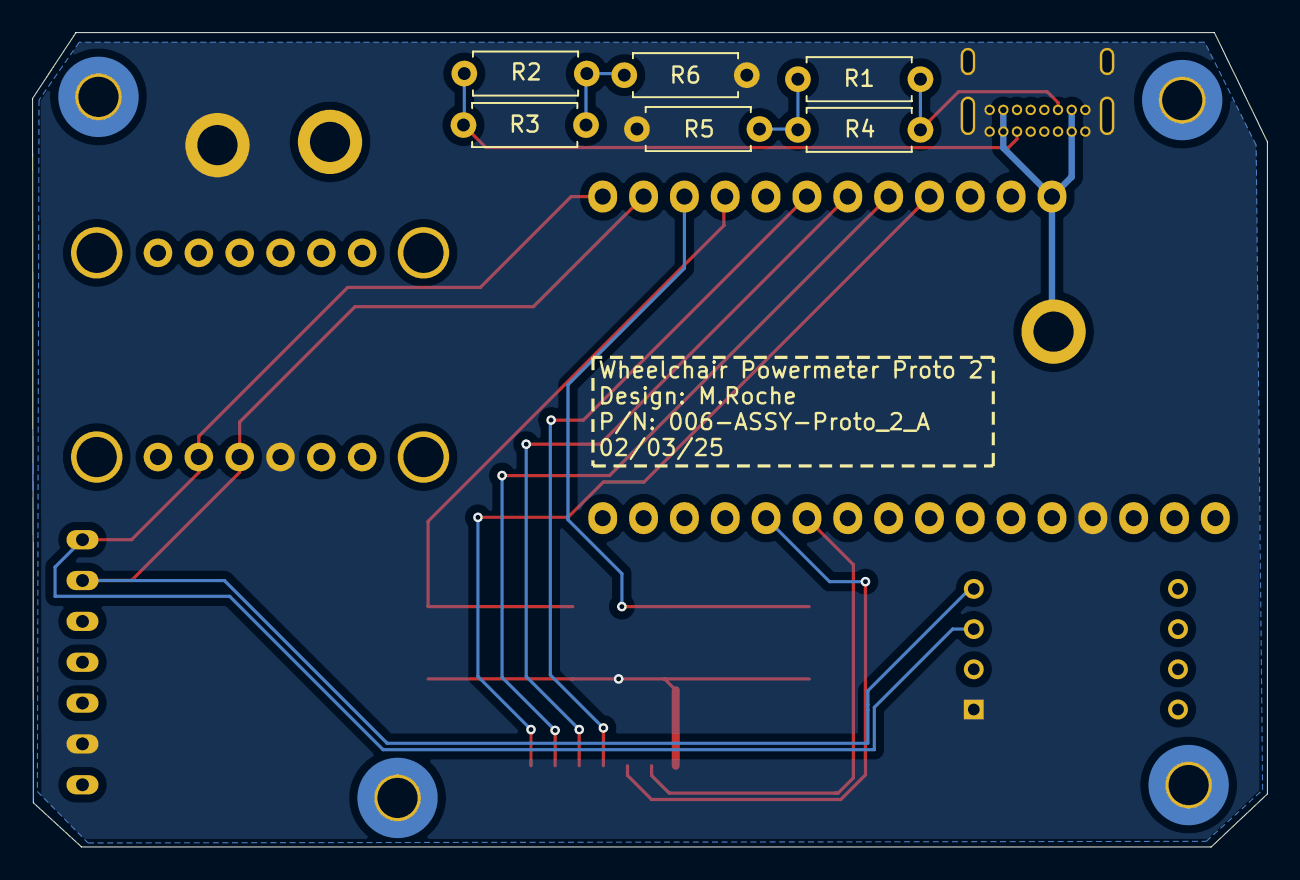
[picture p48: board Wheelchair Powermeter PCB.kicad_pcb from below]

Board: 2 copper layers, 76.8 x 50.7 mm, 17 parts (6 on the bottom side), 17 nets.
