MattERoche/Wheelchair-Powermeter/(commit log)

2025-02-20 Data Commit
    [000006.csv, 000008.csv, 000010.csv, 000013.csv, Main_Run_1.csv, Powermetertest.csv]
2025-02-21 Power Module Commit
2025-02-22 code.py Garbage collect and I2C optimisation
2025-03-03 PCB ADD
    [4525-DS5A001DP.step, Adafruit ESP32 Feather V2.brd, Adafruit ESP32 Feather V2.sch, USB4085-GF-A_REVB.step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]
2025-03-10 PCB Files
    [001-ASSY-POWERMETER.prt, 002-ASSY-EL-PCB.prt, 003-ASSY-CASE.prt, 004-PART-TRAY.prt, 005-PART-LID.prt, 006-PART-BUTTONPUSHER.prt, 007-PART-GLASS.prt, HP0315AFKP2.stp]
2025-03-24 Big dump
    [001-ASSY-POWERMETER.prt, 003-ASSY-CASE.prt, 004-PART-TRAY.prt]
2025-04-02 REorg for sanity and Code Commit
    [000001.csv, 000002.csv, 000006.csv, 000008.csv, 000010.csv, 000013.csv, 001-ASSY-POWERMETER.prt, 002-ASSY-EL-PCB.prt]
2025-04-07 Penultimate commit pre hand in
    [100hz_Test_Deck.csv, 100hz_Test_Deck_PowerCadance.csv, AHEP4 Learning Outcome Matrix 24-25.xlsx]
2025-04-21 Final Commit to main
    [chairtest.csv]
